Taran-the-Idiot/carpet/README.md

# Driving Macropad

What if you had a macropad, that drives????

This is your average macropad by day but with the push of a button it turns into a toy car you can drive around on your desk. It has 4 cherry MX switches and 2 EC11 rotary encoders. For the drive motors it uses 2 N20 motors

It runs off a custom made RP2040 dev board and uses kmk firmware.

## PCB/Electronics

imge

### Schematic



This board runs on a [custom devboard](https://github.com/Taran-the-Idiot/Taranium-RP2040) that was built for this use case that required smaller packaging. 

The motors used for the drive system are N20 motors and they are powered using the L293D motor controlelr.

For the macropad side of things, this board uses a 2x3 matrix with 4 MX keys and 2 encoders. 

In order to preserve size and packaging, a choice was made to avoid using a battery and instead the pad is run off of cable power direct from usb.

### PCB Top Side



### PCB Bottom Side



## CAD



CAD Was made in Shapr3d. It is your basic macropad case but also includes 2 wheels that go directly on the motor shafts and are lined with TPU treads for grip.

The 2 holes on the top of the case exist for the purpose of being able to reach the boot and reset buttons on the microcontroller without having to break open the case.

There are 2 fake wheels on the lower section that exist for the purpose of reducing friction between the pad and the desk due to the lower surface area.

STLs for printing can be found at the [Production/Prints](/Production/Prints/) directory.\
A STEP assembly for editing can be found at the [CAD](/CAD/) directory

## Firmware

This board uses KMK as the driving software for its functionality.

The board has 5 layers in the following format:

- Layer Swap - Used to pick the layer you wish to use
- Audio/Music Control - Used to control your music player
- Keyboard Commands - Commonly used keyboard commands
- Page Controls - Keyboard commands to open/close web pages
- Drive Control - Control how the pad drives

On the driving aspect, you can call the following functions in order to allow the pad to drive:

`forward()` - Move the pad forward\
`backward()` - Move the pad backward\
`turn_right()` - Turn the pad right\
`turn_left()` - Turn the pad left\
`stop()` - Stops both motors

Currently the functions are not tuned to specific degree turns or specific distances.\
However that would more than likely depend and differ between builds so I recommend tuning them yourself anyways to get the desired outcomes.

## BOM

|Item|Count/pack|QTY needed|Packs|Cost(AUD)|Shipping(AUD)|Total(AUD)|Total(USD)|Link|Notes|
|----|---|---|-----|---|---|---|---|----|-----|
|PCB|5|1|1|4.27|2.1|6.37|4.54|JLCpcb.com||
|Switches|10|4|1|4.75|0|4.75||[source](https://www.aliexpress.com/item/1005006425450443.html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)||
|EC11 encoder|5|2|1|6.26|0|6.26||[source](https://www.aliexpress.com/item/1005008583446552.html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)||
|Taranium-RP2040|1|1|1|N/a|N/a|N/a|N/a|[source](https://github.com/Taran-the-Idiot/Taranium-RP2040)|Not Commercially available|
|N20 Motors|1|2|2|3.27|0|6.54||[source](https://www.aliexpress.com/item/1005009244646007.html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)||
|M3X5X4 Heatset Inserts|50|8|1|3.61|0|3.61||[source](https://www.aliexpress.com/item/1005003582355741.html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)||
|L293D|5|1|1|3.59|0|3.59||[source](https://www.aliexpress.com/item/1005010400118009.html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)||
|M3x16mm Screw|50|2|1|3.22|0|3.22||[source](https://www.aliexpress.com/item/4001199728978.html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)||
|M3x25mm Screw|50|2|1|4|0|4||[source](https://www.aliexpress.com/item/4001199728978.html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)||
|M3x6mm Screws|50|4|1|2.55|0|2.55||[source](https://www.aliexpress.com/item/4001199728978.html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)||
|3D Printed Parts||13||N/A|N/A|||YOUR PRINTER|Cost depends on filament used.|
|Total||||||40.89|29.2993206|||
