Taran-the-Idiot/carpet/BOM.csv

Item | Count/pack | QTY needed | Packs | Cost(AUD) | Shipping(AUD) | Total(AUD) | Total(USD) | Link | Notes
PCB | 5 | 1 | 1 | 4.27 | 2.1 | 6.37 | 4.54 | JLCpcb.com
Switches | 10 | 4 | 1 | 4.75 | 0 | 4.75 |  | https://www.aliexpress.com/item/1005006425450443.html?curPageLogUid=G5LWjAJf66HO
EC11 encoder | 5 | 2 | 1 | 6.26 | 0 | 6.26 |  | https://www.aliexpress.com/item/1005008583446552.html?curPageLogUid=EXzHQf5GNgBM
Taranium-RP2040 | 1 | 1 | 1 | N/a | N/a | N/a | N/a | https://github.com/Taran-the-Idiot/Taranium-RP2040 | Not Commercially available
N20 Motors | 1 | 2 | 2 | 3.27 | 0 | 6.54 |  | https://www.aliexpress.com/item/1005009244646007.html?curPageLogUid=rc6I8zs0JHR2
L293D | 5 | 1 | 1 | 3.59 | 0 | 3.59 |  | https://www.aliexpress.com/item/1005010400118009.html?curPageLogUid=J6RLGmCUfqa4
M3X5X4 Heatset Inserts | 50 | 8 | 1 | 3.61 | 0 | 3.61 |  | https://www.aliexpress.com/item/1005003582355741.html?curPageLogUid=jOwKhSwtq9o8
M3x16mm Screw | 50 | 2 | 1 | 3.22 | 0 | 3.22 |  | https://www.aliexpress.com/item/4001199728978.html?curPageLogUid=J1RTS7lEbgbp
M3x25mm Screw | 50 | 2 | 1 | 4 | 0 | 4 |  | https://www.aliexpress.com/item/4001199728978.html?curPageLogUid=J1RTS7lEbgbp
M3x6mm Screws | 50 | 4 | 1 | 2.55 | 0 | 2.55 |  | https://www.aliexpress.com/item/4001199728978.html?curPageLogUid=J1RTS7lEbgbp
3D Printed Parts |  | 13 |  | N/A | N/A |  |  | YOUR PRINTER | Cost depends on filament used.
Total |  |  |  |  |  | 40.89 | 29.2993206
