Taran-the-Idiot/carpet/Production/Prints/Top.stl

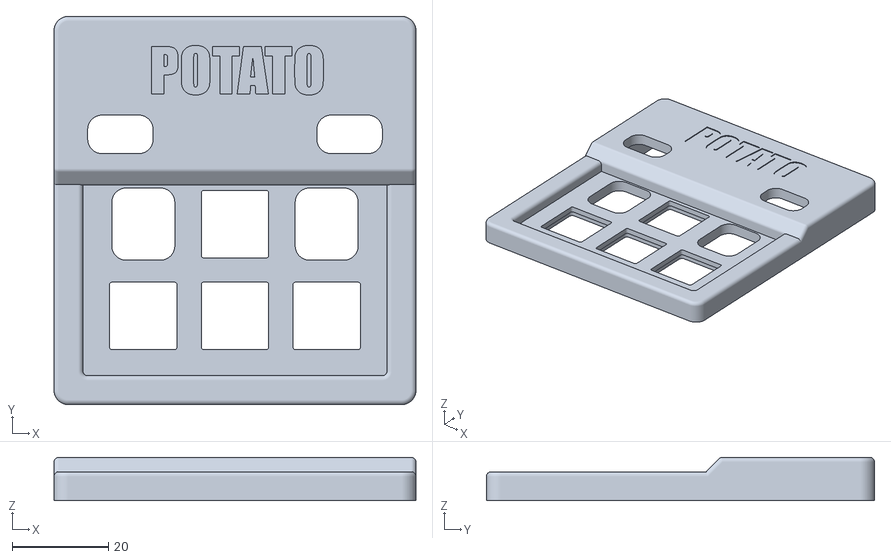
[picture p1: CAD file, 2026-05-26]
Production/Prints/Top.stl
75.2 x 80.6 x 9.00
