Taran-the-Idiot/carpet/Production/Prints/Bottom.stl

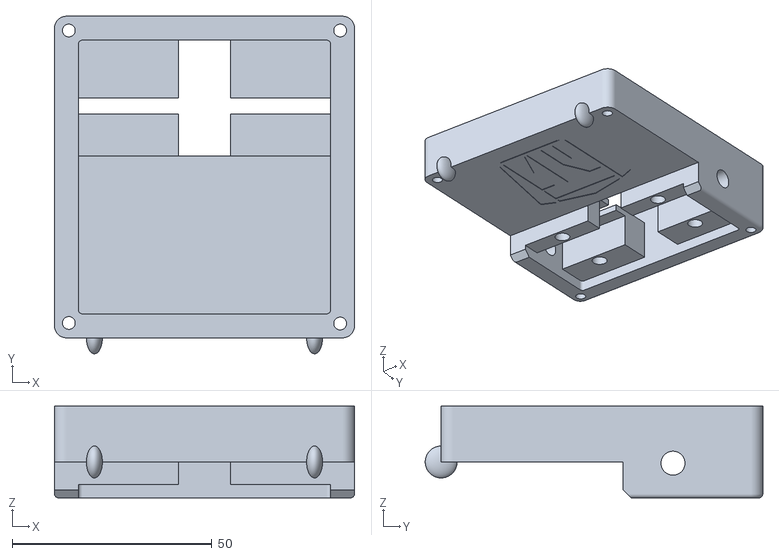
[picture p2: CAD file, 2026-05-26]
Production/Prints/Bottom.stl
75.2 x 84.6 x 23.0
