Taran-the-Idiot/carpet/Production/Prints/Motor Cover.stl

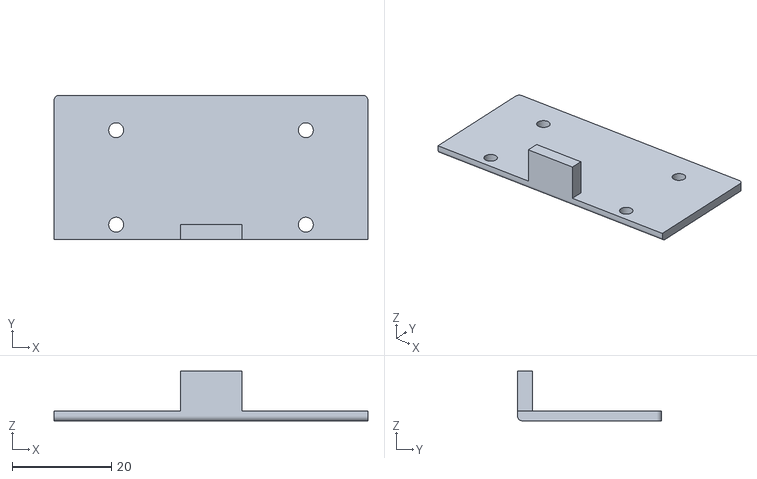
[picture p3: CAD file, 2026-05-26]
Production/Prints/Motor Cover.stl
63.1 x 29.0 x 10.0
