Taran-the-Idiot/carpet/Production/Prints/TPU tread.stl

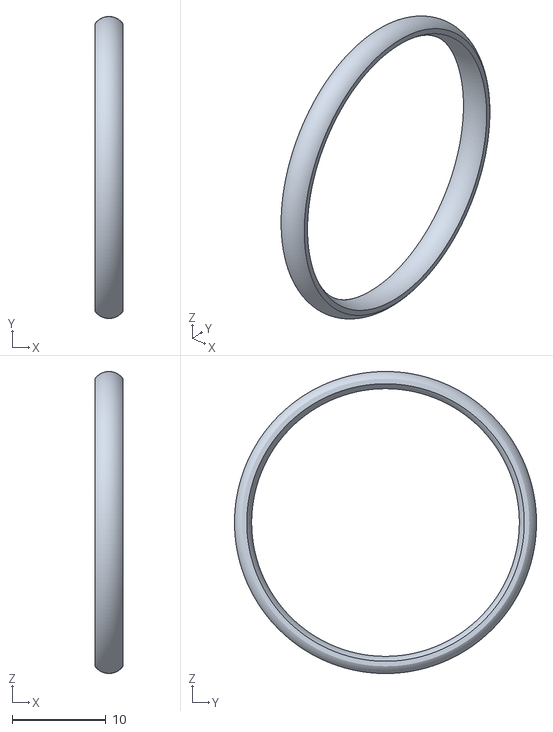
[picture p4: CAD file, 2026-05-26]
Production/Prints/TPU tread.stl
3.00 x 32.3 x 32.3
