Taran-the-Idiot/carpet/PCB/PCB.kicad_pcb

## KiCad design PCB/PCB.kicad_pcb (2026-06-26)

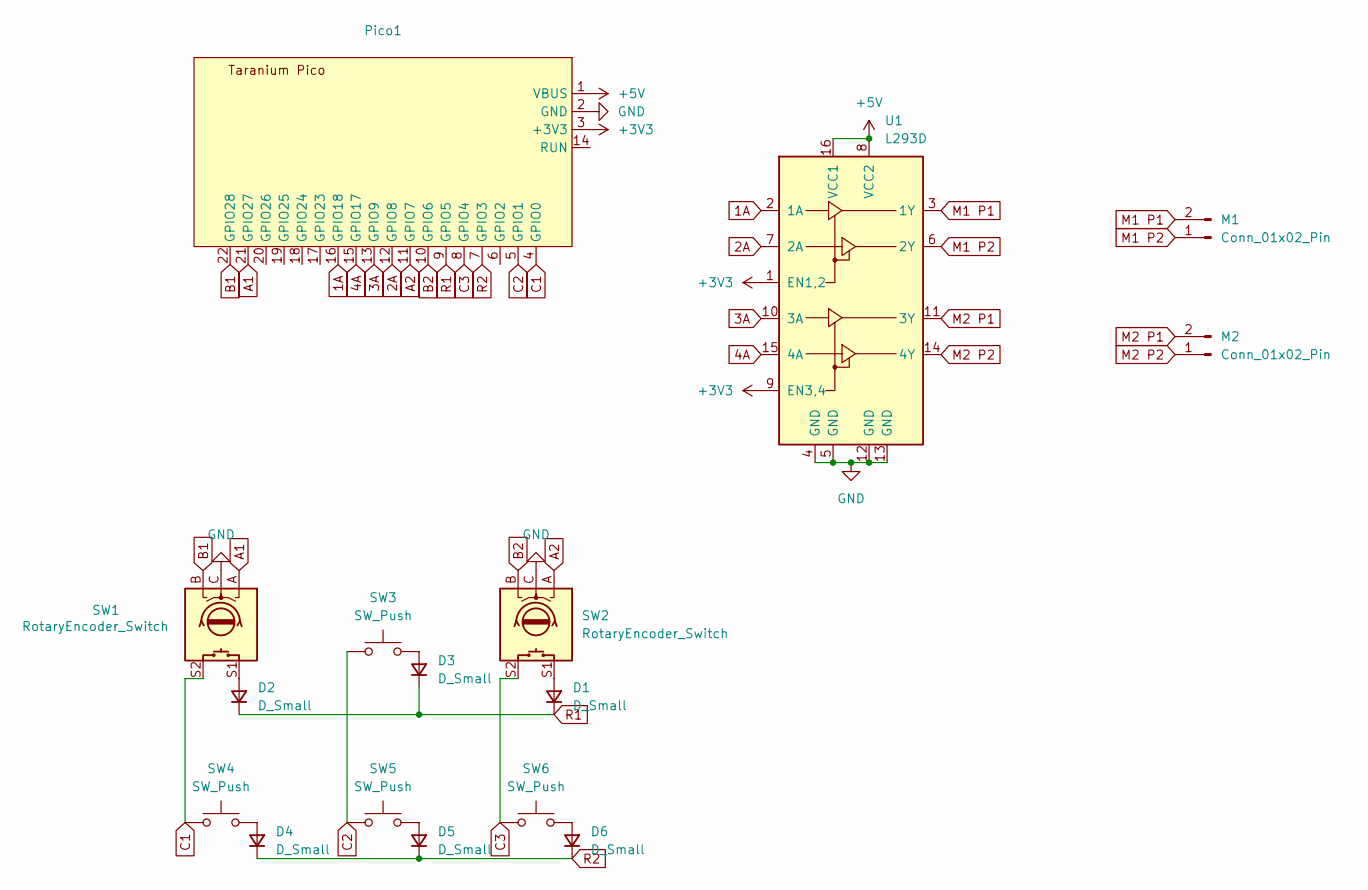
[picture p5: schematic PCB.kicad_sch]

Parts:
D1, D2, D3, D4, D5, D6: D_Small; D_DO-35_SOD27_P7.62mm_Horizontal
M1, M2: Conn_01x02_Pin; PinHeader_1x02_P2.54mm_Vertical
Pico1: Taranium_Pico
SW1, SW2: RotaryEncoder_Switch; RotaryEncoder_Alps_EC11E-Switch_Vertical_H20mm
SW3, SW4, SW5, SW6: SW_Push; SW_Cherry_MX_1.00u_PCB
U1: L293D; DIP-16_W7.62mm

Connections:
1A: Pico1.16 (GPIO18), U1.2 (1A)
2A: Pico1.12 (GPIO8), U1.7 (2A)
3A: Pico1.13 (GPIO9), U1.10 (3A)
4A: Pico1.15 (GPIO17), U1.15 (4A)
+3V3: Pico1.3 (+3V3), U1.1 (EN1,2), U1.9 (EN3,4)
+5V: Pico1.1 (VBUS), U1.8 (VCC2), U1.16 (VCC1)
A1: Pico1.21 (GPIO27), SW1.A
A2: Pico1.11 (GPIO7), SW2.A
B1: Pico1.22 (GPIO28), SW1.B
B2: Pico1.10 (GPIO6), SW2.B
C1: Pico1.4 (GPIO0), SW1.S2, SW4.1
C2: Pico1.5 (GPIO1), SW3.1, SW5.1
C3: Pico1.8 (GPIO4), SW2.S2, SW6.1
GND: Pico1.2 (GND), SW1.C, SW2.C, U1.4 (GND), U1.5 (GND), U1.12 (GND), U1.13 (GND)
M1 P1: M1.2, U1.3 (1Y)
M1 P2: M1.1, U1.6 (2Y)
M2 P1: M2.2, U1.11 (3Y)
M2 P2: M2.1, U1.14 (4Y)
unnamed: D1.2 (A), SW2.S1
unnamed: D2.2 (A), SW1.S1
unnamed: D3.2 (A), SW3.2
unnamed: D4.2 (A), SW4.2
unnamed: D5.2 (A), SW5.2
unnamed: D6.2 (A), SW6.2
R1: D1.1 (K), D2.1 (K), D3.1 (K), Pico1.9 (GPIO5)
R2: D4.1 (K), D5.1 (K), D6.1 (K), Pico1.7 (GPIO3)

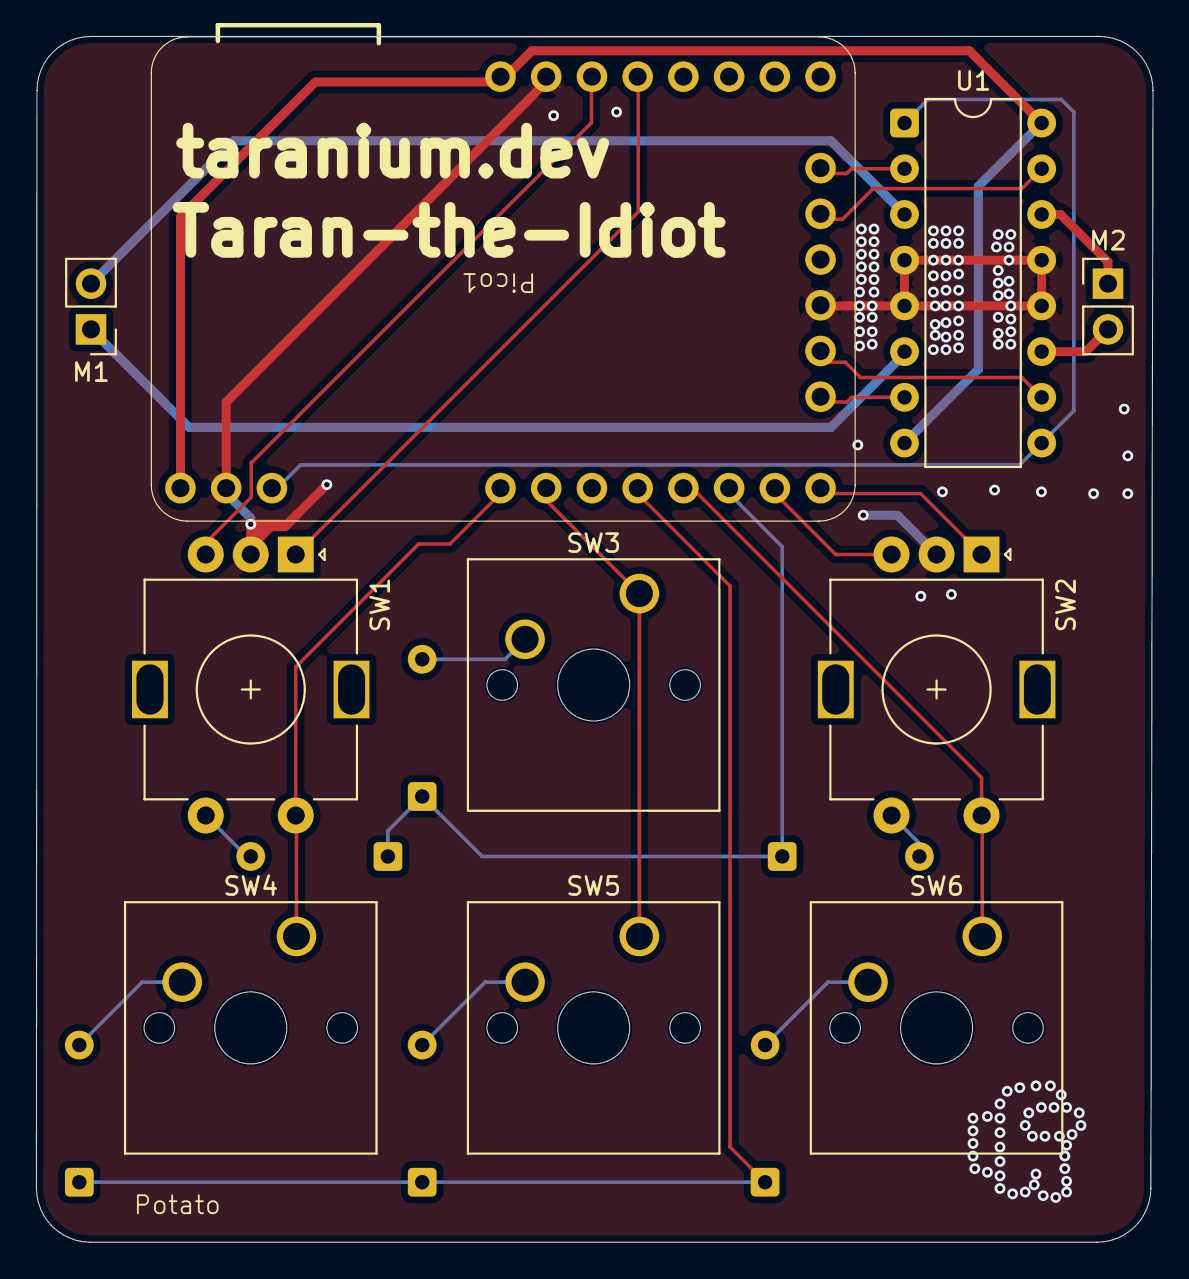
[picture p6: board PCB.kicad_pcb from above]

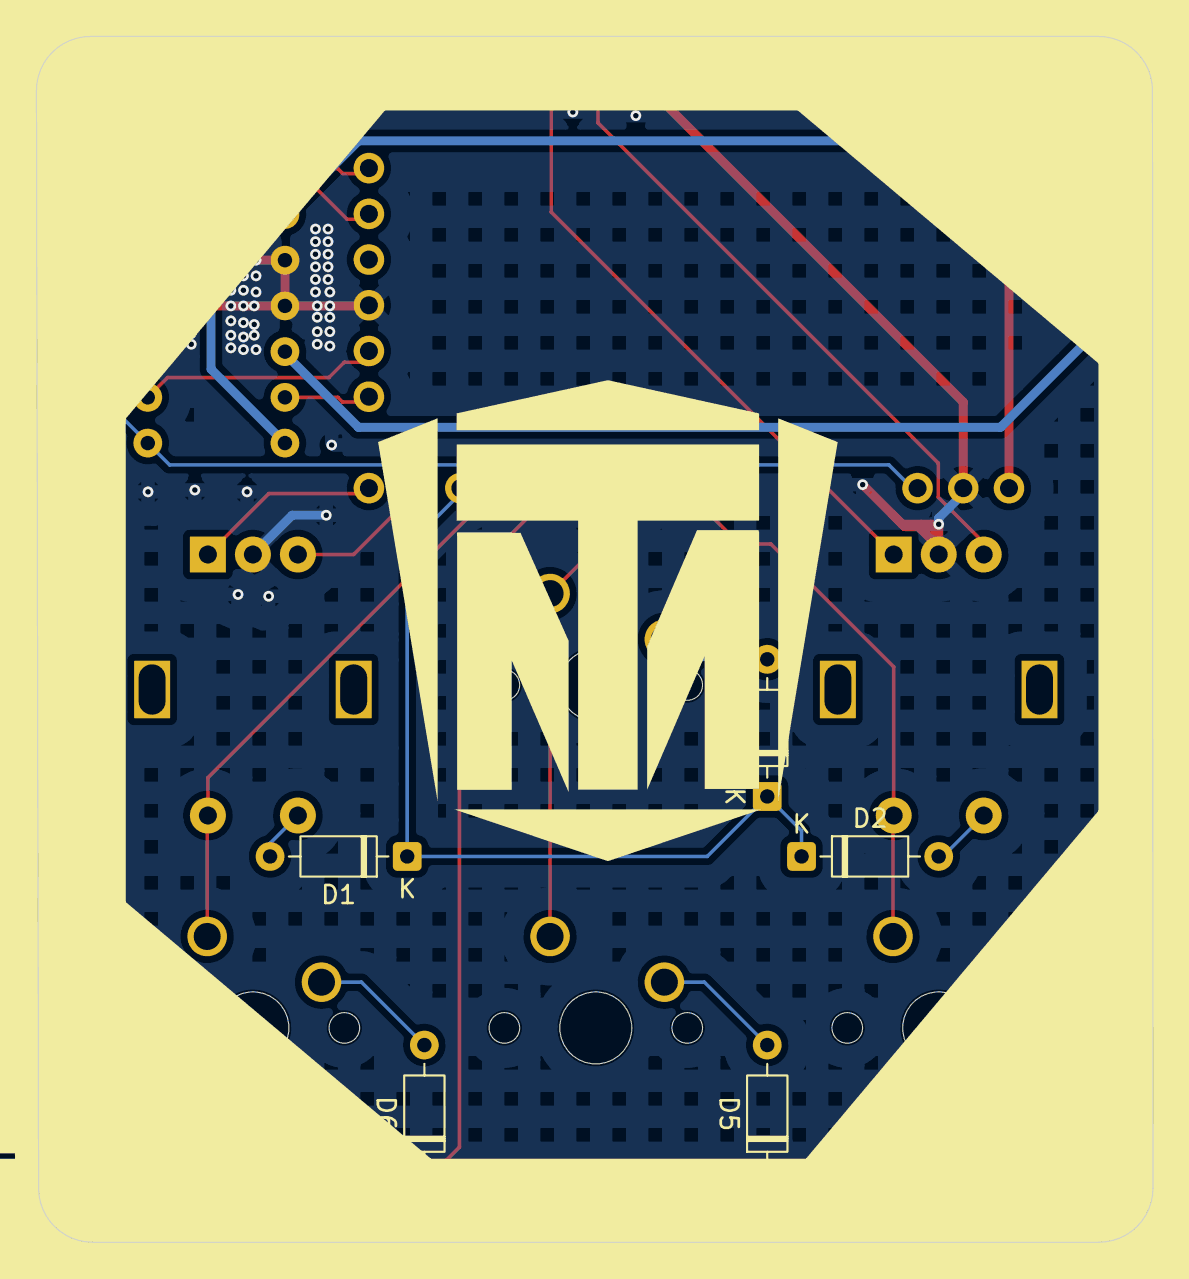
[picture p7: board PCB.kicad_pcb from below]

Board: 2 copper layers, 62.0 x 67.0 mm, 16 parts (6 on the bottom side), 26 nets.
