Taran-the-Idiot/carpet/JOURNAL.md

# A Macropad, that drives????

Total time spent: 19.5 hours

## 2nd of May

Insert sketch here

Tldr: macropad but give it wheels and make it drive

How? probably just continous rotation servos and stuff

Why? idk its funny

Anyways time to make schematic

Okay I got sidetracked by stinky tiktik but starting now at 8:10

first things first i need a microcontrolelr. im not fixing that spelling mistake screw you.

lowkirkuinely might just get a xiao rp2040. its cheapish and works.

the rest is just gonna be 2 servos and some switches, maybe an encoder

imag

parts placed :)

2 encoders cuz encoders are cool, then 4 switches and 2 servos. its gonna be continous rotation servos and not a 270 degree one so it can actually drive. might add a sensor or smth to give it pid but thats a problem for future me to decide.

Okay so i made most of the connections on the schamatic, and I perfectly used every pin



ts so peak.

100% intentional frfr

anyways now time to find some continous rotation servos so i can find voltage

[link](https://www.aliexpress.com/item/1005007614288642.html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)

bazinga

this thingy says I need 4.8-6V so imma hook it up to 5V



Huzzah

banana

Schematic before routing looks like this. its cool ig not much to tlak about

bleh

here is the footprint assignments

onwards to pcb bullshittery

parts

Placed ma parts down. Tried to go for a compactish build(also started routing a bit but thats cuz i forgor to take the ss earlier)

routing

routing yay

Aslso moved arounf the headers for the servos off a bit closer to the microcontroller. probably wont use headers for the real build anyways but imma leave them in for now.

cutlines

added cutlines. plus gave them routed corners. I also used the inbuilt fuction thingy that kicad has for filleting corners. first time using it too. but its a bit funny working when you try to fillet individual lines.

model
 
model generated

mdel2

Found some models for the parts missing models and now finished model(the servos will be in the build cad cuz its gonna be case reliant)

Potato

banan

Here is my finished schematic cuz I needed to change around some of the pin locations since im dum and routing got annoying

okay time to go to cad

Silkscreen stuff imma do later, not bothered rn

Time spent: 1.5 hours (90 mins)

## May 2nd(again)

Splitting this into its own entry cuz like idk shorter entries or smth

plate

plate

not much to it. its 3mm thick

blhe

added the relief cuts/space for it to click/whatever you call em.

since mx switches need 1.5mm plates, and I used 3mm plate, i made a 0.5mm cut on the bottom 1.5mm of the plate so it like allows it to click in instead of friction fit

bleh

imported a servo model into the cad. and lowkey, its pretty big. like really big. and das not very sigmer. so liek, i should probably change that.

Mr nimit told me to use an n20 motor cuz those are small, so thats what I did.

the pcb will stay the same shape so I dont really need to swap that out but I will still need to add in a transistor and change that stuff up a bit. however thats a problem for future me, not now me.

bleh

N20 motors placed

here

Here is what it looks like on the bottom, I might thin out the walls where the motors are so they can have more shaft sticking out.

bazinga

Extend walls

extend downwards

extend downwards and make a hole where the shaft is. the hole is 6mm diameter while the shaft has a 3mm diameter. this way it has wiggle room and room for me to make mistakes.

motoa

Here is what it looks like with the motors in. I will need to make a mount for the motors. I dont wanna just hot glue them.

brotato

wheel. it is being made. wheel go wheel and wheel go spin.



Gave it triangular cutout thingies to reduce weight and stuff(lies its cuz it looks cool)

Also gave it an indent in the middle. will use that indent to either put a bunch of rubber bands or have a tpu insert for grip cuz pla aint gonna cut it

phil

a little fillet goes a long way

fill

added a lot more fillets. this is done for now but im not 100% happy with how it turned out so expect a redesign in the future.

Time spent: 2 hours 30 mins

## 3rd of May 

Didnt do too much today



I just narrowed down the hole for the encoder

I also did a bit of research and found out that the n20 motors have no real mounting holes. meaning I will be infact hot glueing this to the case. but I will also probably have a sandwich with some screws there for the main holding mech.

made these for the motors

made these for the motors. its cool and holds them in place

potato

Now I added these to cover the top. will add screw holes in later but the plan is to have these in with hot glue and then also screwed in with the brace. I also need to figure out how to get the wires around the big thing I made so will also need to figure that out

But those are problems for tomorrow 

Time spent: 30 mins

## 4th of May

So uhhh I kinda forgot to take screenshots of this part but I made the bottom floor, added treads to the tires, and made a top for the microcontroller section. but anyways I got stuck on what to add after that. So what to do so I went back to the pcb to convert it from using servos to using motors. 

After that I reached a big problem. I ran out of pins. since h bridge motor drivers use 2 pins to drive them instead of 1, I need 2 pins that do not exist on my microcontroller. 

After a bit of searching for a potential replacement that has enough pins, I couldn't find anything. so kill me ig. I might just go and make my own. off on a sidequest ig.

Hours spent: 3

(probably spent more but cant remember so putting the bare minimum I would have realistically spent)

## 19th of May

Reterneth I haveth



New microcontroller has been made and has been inserted into boardeth. okay the eths are getting annoying now



Pins. assigned like this. 

Thats it for today

Time spent: 10 mins or smth

## 21st of may



after some back and forth research about good h bridges and stuff, I landed on the L293D cuz everyone just universally says that its good. And i am a sheep that trusts the masses so the L293D is good h bridge that I shall be using



Anyways wired like so



I Assigned the pins like so for now, will probably need to change them



placed the parts and routed the l293d and the power lines. the other lines need their assignments swapped aroind



here is what i landed with



I then moved it a bit cus those pins were closer and I dont want to take the traces on a huge journey across the world(or in this case, further down the street)



I am using a normal fill on the front and a hatch on the back. and I discovered that if you put vias on a hatch fill, it makes this cool pattern. 

except it looks weird if you dont have all the vias fully centred. and I AM NOT gonna be sitting here placing perfect vias on like 200 points.



I WILL however be putting down my amongus vias down in the corner over there



pcb be looking fine af. I still need silkscreen but thats a problem for future me, not now me.

Hours spent: 3

## 26th of May

Made stuff



Added the pcb and adjusted the size of the case to fit it. Cuz the old microcontroller was shorter so case adjustment needed. It only really just needed a cut and some extrusion and remerge. not too bad



I adjusted the position of the motor wire holes because they were slightly misaligned with the slots I made in the case.



Okay this thing was annoying af. I spent like 30 minutes trying to figure out why it wouldnt union with the rest of the case. And after some back and forth between google, I imported it into onshape and tried it and it told me that it basically is illegal to merge the 2 since I made a body have  join at the edge and it needs some kind of full connection or else the file will kill itself





Made a cutout for the usbc plus extra room for the cable



Added a border around the switches to half hide the stems and half make it look better cuz i dont like it when its not contained.



the gray was pissing me off so i went and made everything red again



this was clipping



so i went and rounded out the bottoms of the knobs so it dont clip anymore



looks yummy



added holes mainly to be able to access the boot button and the reset button since I learn from my mistakes and am not gonna remove my access to them again.



tried to make it blend in better and be more non-chanlant but lowkey looks like dog doo-doo.



I moved on the the botton and made the 2 motor covers into 1 piece so its less finicky and also covers up the space at the bottom



also wanna close that gap there



gap has been closed plus gave a small amount of clearance cuz i dont care about an airtight seal



I think i have finally lost my sense for design. my older projects have always been way better than this



i simplified it down back to these 2 holes and i lowkenuienly have no clue how to do this and make it look good.



i give up. we engrave potato on it



put website link here and also put my logo on the bottom of the case



silkscreen. im trying to do a thing



okay it may look sucky but trust the process frfr. it only looks bad now cuz its deisgn file and most of it will get ut off.



tada. its a bit wonky but we can work with it and lowkey looks nice.



renda of the final product.

Hours Spent: 7

## 27th of May

Wrote the firmware. 

I used kmk for this and it was pretty easy. Gave it 4 layers and wrote custom functions for the driving. will probably make it more complex later once I get the thing and am able to tinker but this works technically.

Hours spent: 1

## 29th of May

Made my BOM and submitted :)

Hours spent: 1
