Taran-the-Idiot/carpet/(commit log)

2026-05-02 open sauce is cool
    [PCB.kicad_pcb, PCB.kicad_sch]
2026-05-02 commit ma balls
    [PCB.kicad_pcb, PCB.kicad_sch]
2026-05-29 ima bomb you
    [BOM.csv]
